EthanMeknassi/Camera-Trap-System-Project/README.md

# Camera-Trap-System-Project

## Author
**Ethan Meknassi**

## Introduction
This project was conducted as part of design project for the Department of Electrical Engineering at the University of Cape Town. For a detailed understanding of the project, please refer to the final thesis report entitled: `EEE4113F Final Report Group 24`

## Overview
This repository contains the report of the entire project. The project files must still be added.

## Important Note
Please be aware that only "Chapter 4: ESP32 Initialization and User Interface" was designed by Ethan Meknassi 

Feel free to explore this repository. If you have any questions or encounter issues, please don't hesitate to contact the author, Ethan Meknassi at:

https://www.linkedin.com/in/ethan-meknassi888/
