EthanMeknassi/Camera-Trap-System-Project/LiveStreamingCode/LiveStreamingCode.ino

const char* ssid     = "TP-Link_6024"; 
const char* password = "67084173";  

const char* apssid = "ESP32-CAM";
const char* appassword = "12345678";   

#include <WiFi.h>
#include <WiFiClientSecure.h>
#include "esp_camera.h"    
#include "soc/soc.h"           
#include "soc/rtc_cntl_reg.h" 

String Feedback="";
String Command="",cmd="",P1="",P2="",P3="",P4="",P5="",P6="",P7="",P8="",P9="";
byte ReceiveState=0,cmdState=1,strState=1,questionstate=0,equalstate=0,semicolonstate=0;


#define PWDN_GPIO_NUM     32
#define RESET_GPIO_NUM    -1
#define XCLK_GPIO_NUM      0
#define SIOD_GPIO_NUM     26
#define SIOC_GPIO_NUM     27

#define Y9_GPIO_NUM       35
#define Y8_GPIO_NUM       34
#define Y7_GPIO_NUM       39
#define Y6_GPIO_NUM       36
#define Y5_GPIO_NUM       21
#define Y4_GPIO_NUM       19
#define Y3_GPIO_NUM       18
#define Y2_GPIO_NUM        5
#define VSYNC_GPIO_NUM    25
#define HREF_GPIO_NUM     23
#define PCLK_GPIO_NUM     22

WiFiServer server(80);
WiFiClient client;

void setup() {
  WRITE_PERI_REG(RTC_CNTL_BROWN_OUT_REG, 0);  
  
  Serial.begin(115200);
  Serial.setDebugOutput(true);
  Serial.println();

  camera_config_t config;
  config.ledc_channel = LEDC_CHANNEL_0;
  config.ledc_timer = LEDC_TIMER_0;
  config.pin_d0 = Y2_GPIO_NUM;
  config.pin_d1 = Y3_GPIO_NUM;
  config.pin_d2 = Y4_GPIO_NUM;
  config.pin_d3 = Y5_GPIO_NUM;
  config.pin_d4 = Y6_GPIO_NUM;
  config.pin_d5 = Y7_GPIO_NUM;
  config.pin_d6 = Y8_GPIO_NUM;
  config.pin_d7 = Y9_GPIO_NUM;
  config.pin_xclk = XCLK_GPIO_NUM;
  config.pin_pclk = PCLK_GPIO_NUM;
  config.pin_vsync = VSYNC_GPIO_NUM;
  config.pin_href = HREF_GPIO_NUM;
  config.pin_sscb_sda = SIOD_GPIO_NUM;
  config.pin_sscb_scl = SIOC_GPIO_NUM;
  config.pin_pwdn = PWDN_GPIO_NUM;
  config.pin_reset = RESET_GPIO_NUM;
  config.xclk_freq_hz = 20000000;
  config.pixel_format = PIXFORMAT_JPEG;
  if(psramFound()){
    config.frame_size = FRAMESIZE_UXGA;
    config.jpeg_quality = 10;  
    config.fb_count = 2;
  } else {
    config.frame_size = FRAMESIZE_SVGA;
    config.jpeg_quality = 12; 
    config.fb_count = 1;
  }
  
  // camera init
  esp_err_t err = esp_camera_init(&config);
  if (err != ESP_OK) {
    Serial.printf("Camera init failed with error 0x%x", err);
    delay(1000);
    ESP.restart();
  }

  //drop down frame size for higher initial frame rate
  sensor_t * s = esp_camera_sensor_get();
  s->set_framesize(s, FRAMESIZE_QVGA); 

  ledcAttachPin(4, 4);  
  ledcSetup(4, 5000, 8);    
  
  WiFi.mode(WIFI_AP_STA);  // WiFi.mode(WIFI_AP); WiFi.mode(WIFI_STA);

  //WiFi.config(IPAddress(192, 168, 201, 100), IPAddress(192, 168, 201, 2), IPAddress(255, 255, 255, 0));

  for (int i=0;i<2;i++) {
    //WiFi.begin(ssid, password);  
    delay(1000);
    //Serial.println("");
    //Serial.print("Connecting to ");
    //Serial.println(ssid);
    
    long int StartTime=millis();
  if (WiFi.status() != WL_CONNECTED) {   
    WiFi.softAP((WiFi.softAPIP().toString()+"_"+(String)apssid).c_str(), appassword);         
  
    for (int i=0;i<2;i++) {    
      ledcWrite(4,10);
      delay(1000);
      ledcWrite(4,0);
      delay(1000);    
      }
    }
  } 
  
  //WiFi.softAPConfig(IPAddress(192, 168, 4, 1), IPAddress(192, 168, 4, 1), IPAddress(255, 255, 255, 0)); 
  Serial.println("");
  Serial.println("APIP address: ");
  Serial.println(WiFi.softAPIP());  
  Serial.println("");  

  pinMode(4, OUTPUT);
  digitalWrite(4, LOW);  

  server.begin();          
}

void loop() {
  Feedback="";Command="";cmd="";P1="";P2="";P3="";P4="";P5="";P6="";P7="";P8="";P9="";
  ReceiveState=0,cmdState=1,strState=1,questionstate=0,equalstate=0,semicolonstate=0;
  
  client = server.available();

  if (client) { 
    String currentLine = "";

    while (client.connected()) {
      if (client.available()) {
        char c = client.read();             
        
        getCommand(c);   
                
        if (c == '\n') {
          if (currentLine.length() == 0) {    
            
            if (cmd=="getstill") { 
              getStill(); 
            }
            else if (cmd=="status") {            
              status();           
            }              
            else {  
              mainpage();
            }
                        
            Feedback="";
            break;
          } else {
            currentLine = "";
          }
        } 
        else if (c != '\r') {
          currentLine += c;
        }

        if ((currentLine.indexOf("/?")!=-1)&&(currentLine.indexOf(" HTTP")!=-1)) {
          if (Command.indexOf("stop")!=-1) { 
            client.println();
            client.println();
            client.stop();
          }
          currentLine="";
          Feedback="";
          ExecuteCommand();
        }
      }
    }
    delay(1);
    client.stop();
  }
}

void ExecuteCommand() {
  //Serial.println("");
  //Serial.println("Command: "+Command);
  if (cmd!="getstill") {
    //Serial.println("cmd= "+cmd+" ,P1= "+P1+" ,P2= "+P2+" ,P3= "+P3+" ,P4= "+P4+" ,P5= "+P5+" ,P6= "+P6+" ,P7= "+P7+" ,P8= "+P8+" ,P9= "+P9);
    //Serial.println("");
  }

  if (cmd=="your cmd") {
    // You can do anything
    // Feedback="<font color=\"red\">Hello World</font>";   
  } else if (cmd=="ip") {  
    Feedback="AP IP: "+WiFi.softAPIP().toString();    
    Feedback+="<br>";
    Feedback+="STA IP: "+WiFi.localIP().toString();
  } else if (cmd=="mac") {  
    Feedback="STA MAC: "+WiFi.macAddress();
  } else if (cmd=="restart") {  
    ESP.restart();
  } else if (cmd=="digitalwrite") {  
    ledcDetachPin(P1.toInt());
    pinMode(P1.toInt(), OUTPUT);
    digitalWrite(P1.toInt(), P2.toInt());
  } else if (cmd=="digitalread") {  
    Feedback=String(digitalRead(P1.toInt()));
  } else if (cmd=="analogwrite") { 
    if (P1=="4") {
      ledcAttachPin(4, 4);  
      ledcSetup(4, 5000, 8);
      ledcWrite(4,P2.toInt());     
    } else {
      ledcAttachPin(P1.toInt(), 9);
      ledcSetup(9, 5000, 8);
      ledcWrite(9,P2.toInt());
    }
  }       
  else if (cmd=="analogread") {  
    Feedback=String(analogRead(P1.toInt()));
  } else if (cmd=="touchread") { 
    Feedback=String(touchRead(P1.toInt()));
  } else if (cmd=="restart") { 
    ESP.restart();
  } else if (cmd=="flash") {  
    ledcAttachPin(4, 4);  
    ledcSetup(4, 5000, 8);   
    int val = P1.toInt();
    ledcWrite(4,val);  
  } else if(cmd=="servo") {  
    ledcAttachPin(P1.toInt(), 3);
    ledcSetup(3, 50, 16);
     
    int val = 7864-P2.toInt()*34.59; 
    if (val > 7864)
       val = 7864;
    else if (val < 1638)
      val = 1638; 
    ledcWrite(3, val);
  } else if (cmd=="relay") {  
    pinMode(P1.toInt(), OUTPUT);  
    digitalWrite(P1.toInt(), P2.toInt());
  } else if (cmd=="resetwifi") {   
    for (int i=0;i<2;i++) {
      WiFi.begin(P1.c_str(), P2.c_str());
      Serial.print("Connecting to ");
      Serial.println(P1);
      long int StartTime=millis();
      while (WiFi.status() != WL_CONNECTED) {
          delay(500);
          if ((StartTime+5000) < millis()) break;
      } 
      Serial.println("");
      Serial.println("STAIP: "+WiFi.localIP().toString());
      Feedback="STAIP: "+WiFi.localIP().toString();

      if (WiFi.status() == WL_CONNECTED) {
        WiFi.softAP((WiFi.localIP().toString()+"_"+P1).c_str(), P2.c_str());
        for (int i=0;i<2;i++) {    
          ledcWrite(4,10);
          delay(300);
          ledcWrite(4,0);
          delay(300);    
        }
        break;
      }
    }
  } else if (cmd=="framesize") {
    int val = P1.toInt();
    sensor_t * s = esp_camera_sensor_get(); 
    s->set_framesize(s, (framesize_t)val);    
  } else if (cmd=="quality") {
    sensor_t * s = esp_camera_sensor_get();
    s->set_quality(s, P1.toInt());     
  } else if (cmd=="contrast") {  
    sensor_t * s = esp_camera_sensor_get();
    s->set_contrast(s, P1.toInt());          
  } else if (cmd=="brightness") {  
    sensor_t * s = esp_camera_sensor_get();
    s->set_brightness(s, P1.toInt());   
  } else if (cmd=="saturation") {  
    sensor_t * s = esp_camera_sensor_get();
    s->set_saturation(s, P1.toInt());          
  } else if (cmd=="special_effect") {  
    sensor_t * s = esp_camera_sensor_get();
    s->set_special_effect(s, P1.toInt());  
  } else if (cmd=="hmirror") {  
    sensor_t * s = esp_camera_sensor_get();
    s->set_hmirror(s, P1.toInt());  
  } else if (cmd=="vflip") {  
    sensor_t * s = esp_camera_sensor_get();
    s->set_vflip(s, P1.toInt());  
  } else {
    Feedback="Command is not defined.";
  }
  if (Feedback=="") Feedback=Command;  
}

void getCommand(char c)
{
  if (c=='?') ReceiveState=1;
  if ((c==' ')||(c=='\r')||(c=='\n')) ReceiveState=0;
  
  if (ReceiveState==1)
  {
    Command=Command+String(c);
    
    if (c=='=') cmdState=0;
    if (c==';') strState++;
  
    if ((cmdState==1)&&((c!='?')||(questionstate==1))) cmd=cmd+String(c);
    if ((cmdState==0)&&(strState==1)&&((c!='=')||(equalstate==1))) P1=P1+String(c);
    if ((cmdState==0)&&(strState==2)&&(c!=';')) P2=P2+String(c);
    if ((cmdState==0)&&(strState==3)&&(c!=';')) P3=P3+String(c);
    if ((cmdState==0)&&(strState==4)&&(c!=';')) P4=P4+String(c);
    if ((cmdState==0)&&(strState==5)&&(c!=';')) P5=P5+String(c);
    if ((cmdState==0)&&(strState==6)&&(c!=';')) P6=P6+String(c);
    if ((cmdState==0)&&(strState==7)&&(c!=';')) P7=P7+String(c);
    if ((cmdState==0)&&(strState==8)&&(c!=';')) P8=P8+String(c);
    if ((cmdState==0)&&(strState>=9)&&((c!=';')||(semicolonstate==1))) P9=P9+String(c);
    
    if (c=='?') questionstate=1;
    if (c=='=') equalstate=1;
    if ((strState>=9)&&(c==';')) semicolonstate=1;
  }
}

static const char PROGMEM INDEX_HTML[] = R"rawliteral(<!doctype html>
<html>
    <head>
        <meta charset="utf-8">
        <meta name="viewport" content="width=device-width,initial-scale=1">
        <title>ESP32 Camera Trap Positioning</title>
        <style>
            body {
                font-family: Arial,Helvetica,sans-serif;
                background: #181818;
                color: #EFEFEF;
                font-size: 16px
            }
            h2 {
                font-size: 18px
            }
            section.main {
                display: flex
            }
            #menu,section.main {
                flex-direction: column
            }
            #menu {
                display: none;
                flex-wrap: nowrap;
                min-width: 340px;
                background: #363636;
                padding: 8px;
                border-radius: 4px;
                margin-top: -10px;
                margin-right: 10px;
            }
            #content {
                display: flex;
                flex-wrap: wrap;
                align-items: stretch
            }
            figure {
                padding: 0px;
                margin: 0;
                -webkit-margin-before: 0;
                margin-block-start: 0;
                -webkit-margin-after: 0;
                margin-block-end: 0;
                -webkit-margin-start: 0;
                margin-inline-start: 0;
                -webkit-margin-end: 0;
                margin-inline-end: 0
            }
            figure img {
                display: block;
                width: 100%;
                height: auto;
                border-radius: 4px;
                margin-top: 8px;
            }
            @media (min-width: 800px) and (orientation:landscape) {
                #content {
                    display:flex;
                    flex-wrap: nowrap;
                    align-items: stretch
                }
                figure img {
                    display: block;
                    max-width: 100%;
                    max-height: calc(100vh - 40px);
                    width: auto;
                    height: auto
                }
                figure {
                    padding: 0 0 0 0px;
                    margin: 0;
                    -webkit-margin-before: 0;
                    margin-block-start: 0;
                    -webkit-margin-after: 0;
                    margin-block-end: 0;
                    -webkit-margin-start: 0;
                    margin-inline-start: 0;
                    -webkit-margin-end: 0;
                    margin-inline-end: 0
                }
            }
            section#buttons {
                display: flex;
                flex-wrap: nowrap;
                justify-content: space-between
            }
            #nav-toggle {
                cursor: pointer;
                display: block
            }
            #nav-toggle-cb {
                outline: 0;
                opacity: 0;
                width: 0;
                height: 0
            }
            #nav-toggle-cb:checked+#menu {
                display: flex
            }
            .input-group {
                display: flex;
                flex-wrap: nowrap;
                line-height: 22px;
                margin: 5px 0
            }
            .input-group>label {
                display: inline-block;
                padding-right: 10px;
                min-width: 47%
            }
            .input-group input,.input-group select {
                flex-grow: 1
            }
            .range-max,.range-min {
                display: inline-block;
                padding: 0 5px
            }
            button {
                display: block;
                margin: 5px;
                padding: 0 12px;
                border: 0;
                line-height: 28px;
                cursor: pointer;
                color: #fff;
                background: #ff3034;
                border-radius: 5px;
                font-size: 16px;
                outline: 0
            }
            button:hover {
                background: #ff494d
            }
            button:active {
                background: #f21c21
            }
            button.disabled {
                cursor: default;
                background: #a0a0a0
            }
            input[type=range] {
                -webkit-appearance: none;
                width: 100%;
                height: 22px;
                background: #363636;
                cursor: pointer;
                margin: 0
            }
            input[type=range]:focus {
                outline: 0
            }
            input[type=range]::-webkit-slider-runnable-track {
                width: 100%;
                height: 2px;
                cursor: pointer;
                background: #EFEFEF;
                border-radius: 0;
                border: 0 solid #EFEFEF
            }
            input[type=range]::-webkit-slider-thumb {
                border: 1px solid rgba(0,0,30,0);
                height: 22px;
                width: 22px;
                border-radius: 50px;
                background: #ff3034;
                cursor: pointer;
                -webkit-appearance: none;
                margin-top: -11.5px
            }
            input[type=range]:focus::-webkit-slider-runnable-track {
                background: #EFEFEF
            }
            input[type=range]::-moz-range-track {
                width: 100%;
                height: 2px;
                cursor: pointer;
                background: #EFEFEF;
                border-radius: 0;
                border: 0 solid #EFEFEF
            }
            input[type=range]::-moz-range-thumb {
                border: 1px solid rgba(0,0,30,0);
                height: 22px;
                width: 22px;
                border-radius: 50px;
                background: #ff3034;
                cursor: pointer
            }
            input[type=range]::-ms-track {
                width: 100%;
                height: 2px;
                cursor: pointer;
                background: 0 0;
                border-color: transparent;
                color: transparent
            }
            input[type=range]::-ms-fill-lower {
                background: #EFEFEF;
                border: 0 solid #EFEFEF;
                border-radius: 0
            }
            input[type=range]::-ms-fill-upper {
                background: #EFEFEF;
                border: 0 solid #EFEFEF;
                border-radius: 0
            }
            input[type=range]::-ms-thumb {
                border: 1px solid rgba(0,0,30,0);
                height: 22px;
                width: 22px;
                border-radius: 50px;
                background: #ff3034;
                cursor: pointer;
                height: 2px
            }
            input[type=range]:focus::-ms-fill-lower {
                background: #EFEFEF
            }
            input[type=range]:focus::-ms-fill-upper {
                background: #363636
            }
            .switch {
                display: block;
                position: relative;
                line-height: 22px;
                font-size: 16px;
                height: 22px
            }
            .switch input {
                outline: 0;
                opacity: 0;
                width: 0;
                height: 0
            }
            .slider {
                width: 50px;
                height: 22px;
                border-radius: 22px;
                cursor: pointer;
                background-color: grey
            }
            .slider,.slider:before {
                display: inline-block;
                transition: .4s
            }
            .slider:before {
                position: relative;
                content: "";
                border-radius: 50%;
                height: 16px;
                width: 16px;
                left: 4px;
                top: 3px;
                background-color: #fff
            }
            input:checked+.slider {
                background-color: #ff3034
            }
            input:checked+.slider:before {
                -webkit-transform: translateX(26px);
                transform: translateX(26px)
            }
            select {
                border: 1px solid #363636;
                font-size: 14px;
                height: 22px;
                outline: 0;
                border-radius: 5px
            }
            .image-container {
                position: relative;
                min-width: 160px
            }
            .close {
                position: absolute;
                right: 5px;
                top: 5px;
                background: #ff3034;
                width: 16px;
                height: 16px;
                border-radius: 100px;
                color: #fff;
                text-align: center;
                line-height: 18px;
                cursor: pointer
            }
            .hidden {
                display: none
            }
        </style>
    </head>
    <body>
        <figure>
            <div id="stream-container" class="image-container hidden">
                <div class="close" id="close-stream">×</div>
                <img id="stream" src="">
            </div>
        </figure>     
        <section class="main">
            <div id="logo">
                <label for="nav-toggle-cb" id="nav-toggle">&#9776;&nbsp;&nbsp;Toggle OV2640 settings</label>
            </div>
            <div id="content">
                <div id="sidebar">
                    <input type="checkbox" id="nav-toggle-cb" checked="checked">
                    <nav id="menu">
                        <section id="buttons">
                            <button id="restart">Restart</button>
                            <button id="get-still">Still</button>
                            <button id="stopStream">Stop</button>
                            <button id="startStream">Stream</button>  
                            <button id="turnright">TurnRight</button>  
                                                      
                        </section>           
                        <div class="input-group" id="flash-group">
                            <label for="flash">Flash</label>
                            <div class="range-min">0</div>
                            <input type="range" id="flash" min="0" max="255" value="0" class="default-action">
                            <div class="range-max">255</div>
                        </div>
                        <div class="input-group" id="framesize-group">
                            <label for="framesize">Resolution</label>
                            <select id="framesize" class="default-action">
                                <option value="10">UXGA(1600x1200)</option>
                                <option value="9">SXGA(1280x1024)</option>
                                <option value="8">XGA(1024x768)</option>
                                <option value="7">SVGA(800x600)</option>
                                <option value="6">VGA(640x480)</option>
                                <option value="5" selected="selected">CIF(400x296)</option>
                                <option value="4">QVGA(320x240)</option>
                                <option value="3">HQVGA(240x176)</option>
                                <option value="0">QQVGA(160x120)</option>
                            </select>
                        </div>
                        <div class="input-group" id="quality-group">
                            <label for="quality">Quality</label>
                            <div class="range-min">10</div>
                            <input type="range" id="quality" min="10" max="63" value="10" class="default-action">
                            <div class="range-max">63</div>
                        </div>
                        <div class="input-group" id="brightness-group">
                            <label for="brightness">Brightness</label>
                            <div class="range-min">-2</div>
                            <input type="range" id="brightness" min="-2" max="2" value="0" class="default-action">
                            <div class="range-max">2</div>
                        </div>
                        <div class="input-group" id="contrast-group">
                            <label for="contrast">Contrast</label>
                            <div class="range-min">-2</div>
                            <input type="range" id="contrast" min="-2" max="2" value="0" class="default-action">
                            <div class="range-max">2</div>
                        </div>
                        <div class="input-group" id="saturation-group">
                            <label for="saturation">Saturation</label>
                            <div class="range-min">-2</div>
                            <input type="range" id="saturation" min="-2" max="2" value="0" class="default-action">
                            <div class="range-max">2</div>
                        </div>
                        <div class="input-group" id="special_effect-group">
                            <label for="special_effect">Special Effect</label>
                            <select id="special_effect" class="default-action">
                                <option value="0" selected="selected">No Effect</option>
                                <option value="1">Negative</option>
                                <option value="2">Grayscale</option>
                                <option value="3">Red Tint</option>
                                <option value="4">Green Tint</option>
                                <option value="5">Blue Tint</option>
                                <option value="6">Sepia</option>
                            </select>
                        </div>
                        <div class="input-group" id="hmirror-group">
                            <label for="hmirror">H-Mirror</label>
                            <div class="switch">
                                <input id="hmirror" type="checkbox" class="default-action" checked="checked">
                                <label class="slider" for="hmirror"></label>
                            </div>
                        </div>
                        <div class="input-group" id="vflip-group">
                            <label for="vflip">V-Flip</label>
                            <div class="switch">
                                <input id="vflip" type="checkbox" class="default-action" checked="checked">
                                <label class="slider" for="vflip"></label>
                            </div>
                        </div>
                    </nav>
                </div>
            </div>
        </section>
        <span id="message" style="color:red"></span>
        <script>
document.addEventListener('DOMContentLoaded', function (event) {
  var baseHost = document.location.origin
  const hide = el => {
    el.classList.add('hidden')
  }
  const show = el => {
    el.classList.remove('hidden')
  }
  const disable = el => {
    el.classList.add('disabled')
    el.disabled = true
  }
  const enable = el => {
    el.classList.remove('disabled')
    el.disabled = false
  }
  const updateValue = (el, value, updateRemote) => {
    updateRemote = updateRemote == null ? true : updateRemote
    let initialValue
    if (el.type === 'checkbox') {
      initialValue = el.checked
      value = !!value
      el.checked = value
    } else {
      initialValue = el.value
      el.value = value
    }
    if (updateRemote && initialValue !== value) {
      updateConfig(el);
    }
  }
  function updateConfig (el) {
    let value
    switch (el.type) {
      case 'checkbox':
        value = el.checked ? 1 : 0
        break
      case 'range':
      case 'select-one':
        value = el.value
        break
      case 'button':
      case 'submit':
        value = '1'
        break
      default:
        return
    }
    var query = `${baseHost}/?${el.id}=${value}`
    fetch(query)
      .then(response => {
        console.log(`request to ${query} finished, status: ${response.status}`)
      })
  }
  document
    .querySelectorAll('.close')
    .forEach(el => {
      el.onclick = () => {
        hide(el.parentNode)
      }
    })
  // read initial values
  fetch(`${baseHost}/?status`)
    .then(function (response) {
      return response.json()
    })
    .then(function (state) {
      document
        .querySelectorAll('.default-action')
        .forEach(el => {
          if (el.id=="flash") {  
            flash.value=0;
            fetch(baseHost+"/?flash=0");
          } else {    
            updateValue(el, state[el.id], false)
          }
        })
    })
  const view = document.getElementById('stream')
  const viewContainer = document.getElementById('stream-container')
  const stillButton = document.getElementById('get-still')
  const streamButton = document.getElementById('startStream')
  const turnright = document.getElementById('turnright')
  const stopButton = document.getElementById('stopStream')
  const closeButton = document.getElementById('close-stream')
  const message = document.getElementById('message');
  const restartButton = document.getElementById('restart')         
  const flash = document.getElementById('flash')                    
  var myTimer;
  var restartCount=0;    
  var streamState = false;
  var turning = false;
  
  streamButton.onclick = function (event) {
    clearInterval(myTimer);
    streamState=true;
    myTimer = setInterval(function(){error_handle();},5000); 
    view.src = location.origin+'/?getstill='+Math.random();
    show(viewContainer);
  }
  turnright.onclick = function (event) {
    clearInterval(myTimer);    
    turning=true;    
    ;
    message.innerHTML = "";

  function error_handle() {
    restartCount++;
    clearInterval(myTimer);
    if (restartCount<=2) {
      message.innerHTML = "Get still error. <br>Try to get still "+restartCount+" times.";
      myTimer = setInterval(function(){streamButton.click();},10000);
    }
    else
      message.innerHTML = "Get still error. <br>Please reload the page or check ESP32-CAM board.";
  }
  
  view.onload = function (event) {
    clearInterval(myTimer);
    restartCount=0;      
    if (streamState==false) return;
    streamButton.click();
  }        
  
  stopButton.onclick = function (event) {
    clearInterval(myTimer);    
    streamState=false;    
    window.stop();
    message.innerHTML = "";
  }    
   
  // Attach actions to buttons
  stillButton.onclick = () => {
    stopButton.click();
    view.src = `${baseHost}/?getstill=${Date.now()}`
    show(viewContainer);     
  }
  closeButton.onclick = () => {
    hide(viewContainer)
  }
  
  restartButton.onclick = () => {
    fetch(baseHost+"/?restart");
  }    
  // Attach default on change action
  document
    .querySelectorAll('.default-action')
    .forEach(el => {
      el.onchange = () => updateConfig(el)
    })
  // framesize
  const framesize = document.getElementById('framesize')
  framesize.onchange = () => {
    updateConfig(framesize)
  }
})
        </script>
    </body>
</html>)rawliteral";

void status(){
  
  sensor_t * s = esp_camera_sensor_get();
  String json = "{";
  json += "\"framesize\":"+String(s->status.framesize)+",";
  json += "\"quality\":"+String(s->status.quality)+",";
  json += "\"brightness\":"+String(s->status.brightness)+",";
  json += "\"contrast\":"+String(s->status.contrast)+",";
  json += "\"saturation\":"+String(s->status.saturation)+",";
  json += "\"special_effect\":"+String(s->status.special_effect)+",";
  json += "\"vflip\":"+String(s->status.vflip)+",";
  json += "\"hmirror\":"+String(s->status.hmirror);
  json += "}";
  
  client.println("HTTP/1.1 200 OK");
  client.println("Access-Control-Allow-Headers: Origin, X-Requested-With, Content-Type, Accept");
  client.println("Access-Control-Allow-Methods: GET,POST,PUT,DELETE,OPTIONS");
  client.println("Content-Type: application/json; charset=utf-8");
  client.println("Access-Control-Allow-Origin: *");
  client.println("Connection: close");
  client.println();
  
  for (int Index = 0; Index < json.length(); Index = Index+1024) {
    client.print(json.substring(Index, Index+1024));
  }
}

void mainpage() {
  client.println("HTTP/1.1 200 OK");
  client.println("Access-Control-Allow-Headers: Origin, X-Requested-With, Content-Type, Accept");
  client.println("Access-Control-Allow-Methods: GET,POST,PUT,DELETE,OPTIONS");
  client.println("Content-Type: text/html; charset=utf-8");
  client.println("Access-Control-Allow-Origin: *");
  client.println("Connection: close");
  client.println();
  
  String Data="";
  if (cmd!="")
    Data = Feedback;
  else
    Data = String((const char *)INDEX_HTML);
  
  for (int Index = 0; Index < Data.length(); Index = Index+1024) {
    client.print(Data.substring(Index, Index+1024));
  } 
}

void getStill() {
  camera_fb_t * fb = NULL;
  fb = esp_camera_fb_get();  
  if(!fb) {
    Serial.println("Camera capture failed");
    delay(1000);
    ESP.restart();
  }

  client.println("HTTP/1.1 200 OK");
  client.println("Access-Control-Allow-Origin: *");              
  client.println("Access-Control-Allow-Headers: Origin, X-Requested-With, Content-Type, Accept");
  client.println("Access-Control-Allow-Methods: GET,POST,PUT,DELETE,OPTIONS");
  client.println("Content-Type: image/jpeg");
  client.println("Content-Disposition: form-data; name=\"imageFile\"; filename=\"picture.jpg\""); 
  client.println("Content-Length: " + String(fb->len));             
  client.println("Connection: close");
  client.println();
  
  uint8_t *fbBuf = fb->buf;
  size_t fbLen = fb->len;
  for (size_t n=0;n<fbLen;n=n+1024) {
    if (n+1024<fbLen) {
      client.write(fbBuf, 1024);
      fbBuf += 1024;
    }
    else if (fbLen%1024>0) {
      size_t remainder = fbLen%1024;
      client.write(fbBuf, remainder);
    }
  }  
  esp_camera_fb_return(fb);

  pinMode(4, OUTPUT);
  digitalWrite(4, LOW);              
}
