EthanMeknassi/Camera-Trap-System-Project/testimgdownload/testimgdownload.ino

#include <DHT.h>
#include "esp_camera.h"
#include "Arduino.h"
#include "FS.h"                // SD Card ESP32
#include "SD_MMC.h"            // SD Card ESP32
#include "soc/soc.h"           // Disable brownour problems //cc
#include "soc/rtc_cntl_reg.h"  // Disable brownour problems//cc
#include "driver/rtc_io.h" //cc
#include <EEPROM.h> 
#include <ESPmDNS.h>
#include <ESP32Servo.h>
#include <analogWrite.h>
#include <ESP32Tone.h>
#include <ESP32PWM.h>
#include "WiFi.h"
#include "esp_camera.h"
#include "esp_timer.h"
#include "img_converters.h"
#include "Arduino.h"
#include "fb_gfx.h"
#include "esp_http_server.h"
#include "soc/soc.h"           // Disable brownour problems
#include "soc/rtc_cntl_reg.h"  // Disable brownour problems
#include "driver/rtc_io.h"
#include <WebServer.h>
//#include <StringArray.h>
#include <FS.h>
#include "SD_MMC.h"            // SD Card ESP32
#include <FSImpl.h>
#include <vfs_api.h>
#include <EEPROM.h>            // read and write from flash memory


#include <WiFi.h>              //Built-in
#include <ESPmDNS.h>

#include "CSS.h" //Includes headers of the web and de style file
#include <SD.h> 
#include <SPI.h>

WebServer server(80);

#define servername "Camera-Trap Wireless Server" //Define the name to your server... 

const char* ssid = "ESP32";
const char* password = "12345678";

IPAddress local_ip(192,168,1,1);
IPAddress gateway(192,168,1,1);
IPAddress subnet(255,255,255,0);

bool   SD_present = false; //Controls if the SD card is present or not

/*********  SETUP  **********/

void setup(void)
{  
  Serial.begin(115200);
  WiFi.softAP(ssid, password);
  WiFi.softAPConfig(local_ip, gateway, subnet);


  Serial.print(F("Initializing SD card..."));
  fs::FS &fs = SD_MMC; 

  //Note: Using the ESP32 and SD_Card readers requires a 1K to 4K7 pull-up to 3v3 on the MISO line, otherwise may not work
  if (!SD_MMC.begin())
  { 
    Serial.println(F("Card failed or not present, no SD Card data logging possible..."));
    SD_present = false; 
  } 
  else
  {
    Serial.println(F("Card initialised... file access enabled..."));
    SD_present = true; 
  }
  
  /*********  Server Commands  **********/
  server.on("/",         SD_dir);
  server.begin();
  
  Serial.println("HTTP server started");
}

/*********  LOOP  **********/
void loop(void)
{
  server.handleClient(); //Listen for client connections
}

/*********  FUNCTIONS  **********/
//Initial page of the server web, list directory and give you the chance of deleting and uploading
void SD_dir()
{
  if (SD_present) 
  {
    //Action acording to post, dowload or delete, by MC 2022
    if (server.args() > 0 ) //Arguments were received, ignored if there are not arguments
    { 
      Serial.println(server.arg(0));
  
      String Order = server.arg(0);
      Serial.println(Order);
      
      if (Order.indexOf("download_")>=0)
      {
        Order.remove(0,9);
        SD_file_download(Order);
        Serial.println(Order);
      }
  
      if ((server.arg(0)).indexOf("delete_")>=0)
      {
        Order.remove(0,7);
        SD_file_delete(Order);
        Serial.println(Order);
      }
    }

    File root = SD_MMC.open("/");
    if (root) {
      root.rewindDirectory();
      SendHTML_Header();    
      webpage += F("<table align='center'>");
      webpage += F("<tr><th>Picture Name</th><th style='width:20%'>Directory</th><th>Size</th></tr>");
      printDirectory("/",0);
      webpage += F("</table>");
      SendHTML_Content();
      root.close();
    }
    else 
    {
      SendHTML_Header();
      webpage += F("<h3>No Files Found</h3>");
    }
    append_page_footer();
    SendHTML_Content();
    SendHTML_Stop();   //Stop is needed because no content length was sent
  } else ReportSDNotPresent();
}

//Prints the directory, it is called in void SD_dir() 
void printDirectory(const char * dirname, uint8_t levels)
{
  
  File root = SD_MMC.open(dirname);

  if(!root){
    return;
  }
  if(!root.isDirectory()){
    return;
  }
  File file = root.openNextFile();

  int i = 0;
  while(file){
    if (webpage.length() > 1000) {
      SendHTML_Content();
    }
    if(file.isDirectory()){
      webpage += "<tr><td>"+String(file.isDirectory()?"Dir":"File")+"</td><td>"+String(file.name())+"</td><td></td></tr>";
      printDirectory(file.name(), levels-1);
    }
    else
    {
      webpage += "<tr><td>"+String(file.name())+"</td>";
      webpage += "<td>"+String(file.isDirectory()?"Dir":"File")+"</td>";
      int bytes = file.size();
      String fsize = "";
      if (bytes < 1024)                     fsize = String(bytes)+" B";
      else if(bytes < (1024 * 1024))        fsize = String(bytes/1024.0,3)+" KB";
      else if(bytes < (1024 * 1024 * 1024)) fsize = String(bytes/1024.0/1024.0,3)+" MB";
      else                                  fsize = String(bytes/1024.0/1024.0/1024.0,3)+" GB";
      webpage += "<td>"+fsize+"</td>";
      webpage += "<td>";
      webpage += F("<FORM action='/' method='post'>"); 
      webpage += F("<button type='submit' name='download'"); 
      webpage += F("' value='"); webpage +="download_"+String(file.name()); webpage +=F("'>Download</button>");
      webpage += "</td>";
      webpage += "<td>";
      webpage += F("<FORM action='/' method='post'>"); 
      webpage += F("<button type='submit' name='delete'"); 
      webpage += F("' value='"); webpage +="delete_"+String(file.name()); webpage +=F("'>Delete</button>");
      webpage += "</td>";
      webpage += "</tr>";

    }
    file = root.openNextFile();
    i++;
  }
  file.close();

 
}

//Download a file from the SD, it is called in void SD_dir()
void SD_file_download(String filename)
{
  if (SD_present) 
  { 
    File download = SD_MMC.open("/"+filename);
    if (download) 
    {
      server.sendHeader("Content-Type", "text/text");
      server.sendHeader("Content-Disposition", "attachment; filename="+filename);
      server.sendHeader("Connection", "close");
      server.streamFile(download, "application/octet-stream");
      download.close();
    } else ReportFileNotPresent("download"); 
  } else ReportSDNotPresent();
}

//Delete a file from the SD, it is called in void SD_dir()
void SD_file_delete(String filename) 
{ 
  if (SD_present) { 
    SendHTML_Header();
    File dataFile = SD_MMC.open("/"+filename, FILE_READ); //Now read data from SD Card 
    if (dataFile)
    {
      if (SD.remove("/"+filename)) {
        Serial.println(F("File deleted successfully"));
        webpage += "<h3>File '"+filename+"' has been erased</h3>"; 
        webpage += F("<a href='/'>[Back]</a><br><br>");
      }
      else
      { 
        webpage += F("<h3>File was not deleted - error</h3>");
        webpage += F("<a href='/'>[Back]</a><br><br>");
      }
    } else ReportFileNotPresent("delete");
    append_page_footer(); 
    SendHTML_Content();
    SendHTML_Stop();
  } else ReportSDNotPresent();
} 

//SendHTML_Header
void SendHTML_Header()
{
  server.sendHeader("Cache-Control", "no-cache, no-store, must-revalidate"); 
  server.sendHeader("Pragma", "no-cache"); 
  server.sendHeader("Expires", "-1"); 
  server.setContentLength(CONTENT_LENGTH_UNKNOWN); 
  server.send(200, "text/html", ""); //Empty content inhibits Content-length header so we have to close the socket ourselves. 
  append_page_header();
  server.sendContent(webpage);
  webpage = "";
}

//SendHTML_Content
void SendHTML_Content()
{
  server.sendContent(webpage);
  webpage = "";
}

//SendHTML_Stop
void SendHTML_Stop()
{
  server.sendContent("");
  server.client().stop(); //Stop is needed because no content length was sent
}

//ReportSDNotPresent
void ReportSDNotPresent()
{
  SendHTML_Header();
  webpage += F("<h3>No SD Card present</h3>"); 
  webpage += F("<a href='/'>[Back]</a><br><br>");
  append_page_footer();
  SendHTML_Content();
  SendHTML_Stop();
}

//ReportFileNotPresent
void ReportFileNotPresent(String target)
{
  SendHTML_Header();
  webpage += F("<h3>File does not exist</h3>"); 
  webpage += F("<a href='/"); webpage += target + "'>[Back]</a><br><br>";
  append_page_footer();
  SendHTML_Content();
  SendHTML_Stop();
}

//ReportCouldNotCreateFile
void ReportCouldNotCreateFile(String target)
{
  SendHTML_Header();
  webpage += F("<h3>Could Not Create Uploaded File (write-protected?)</h3>"); 
  webpage += F("<a href='/"); webpage += target + "'>[Back]</a><br><br>";
  append_page_footer();
  SendHTML_Content();
  SendHTML_Stop();
}

//File size conversion
String file_size(int bytes)
{
  String fsize = "";
  if (bytes < 1024)                 fsize = String(bytes)+" B";
  else if(bytes < (1024*1024))      fsize = String(bytes/1024.0,3)+" KB";
  else if(bytes < (1024*1024*1024)) fsize = String(bytes/1024.0/1024.0,3)+" MB";
  else                              fsize = String(bytes/1024.0/1024.0/1024.0,3)+" GB";
  return fsize;
}
